srspinho/KBD_16_MENU/hardware/fab/kbd16_esquematico.pdf

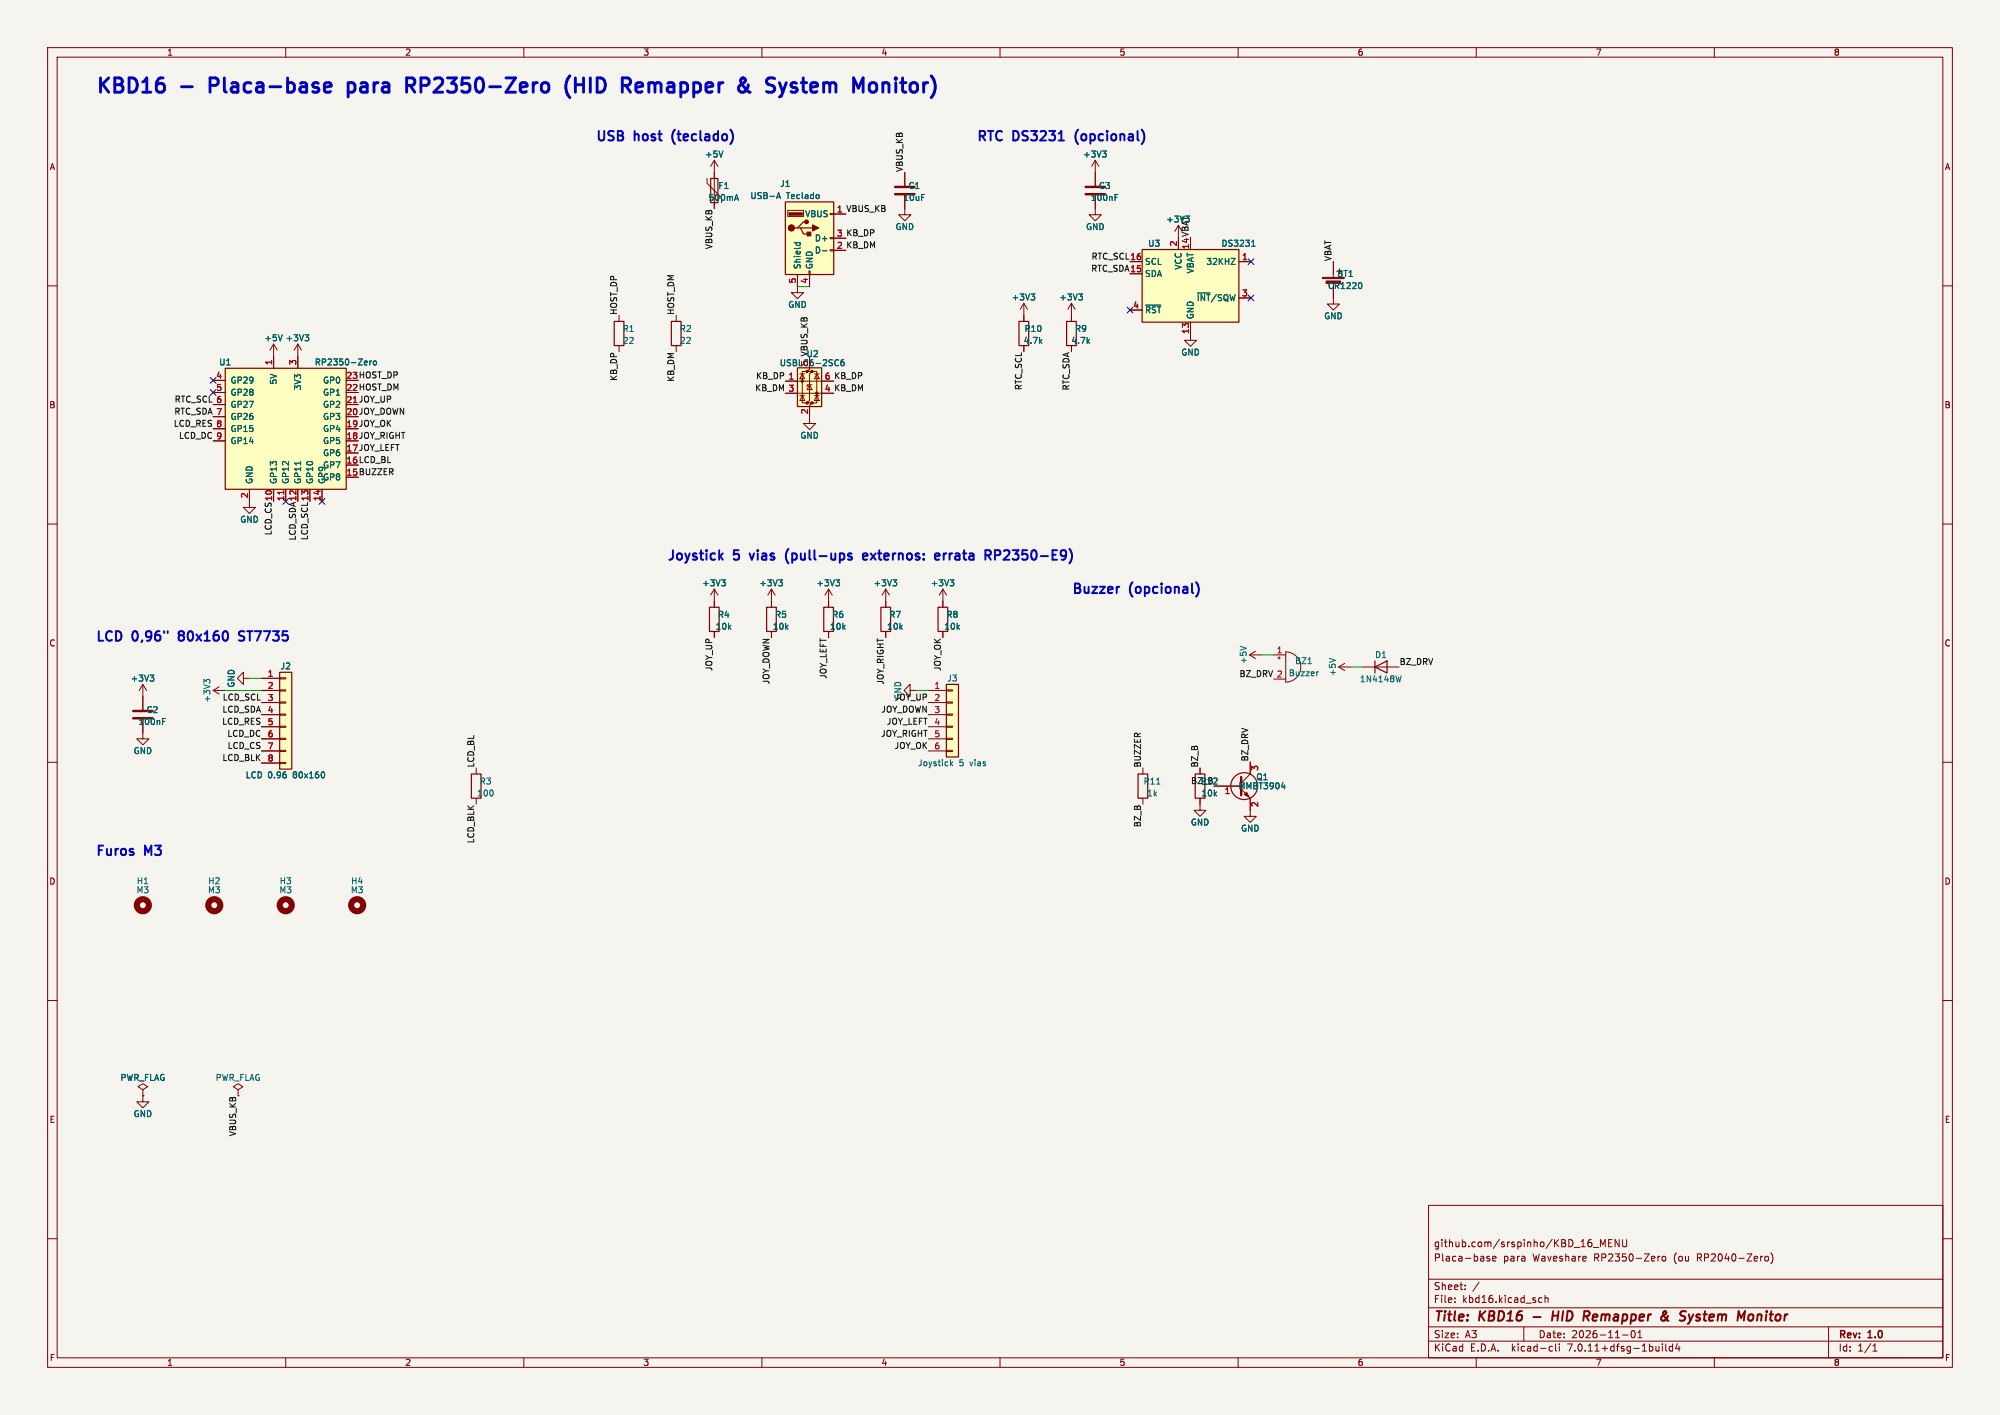
[picture p3: page 1]

2 ~{INT}/SQW3 ~{RST} 4 GND GND
