srspinho/KBD_16_MENU/hardware/fab/kbd16_placa_1x1.pdf

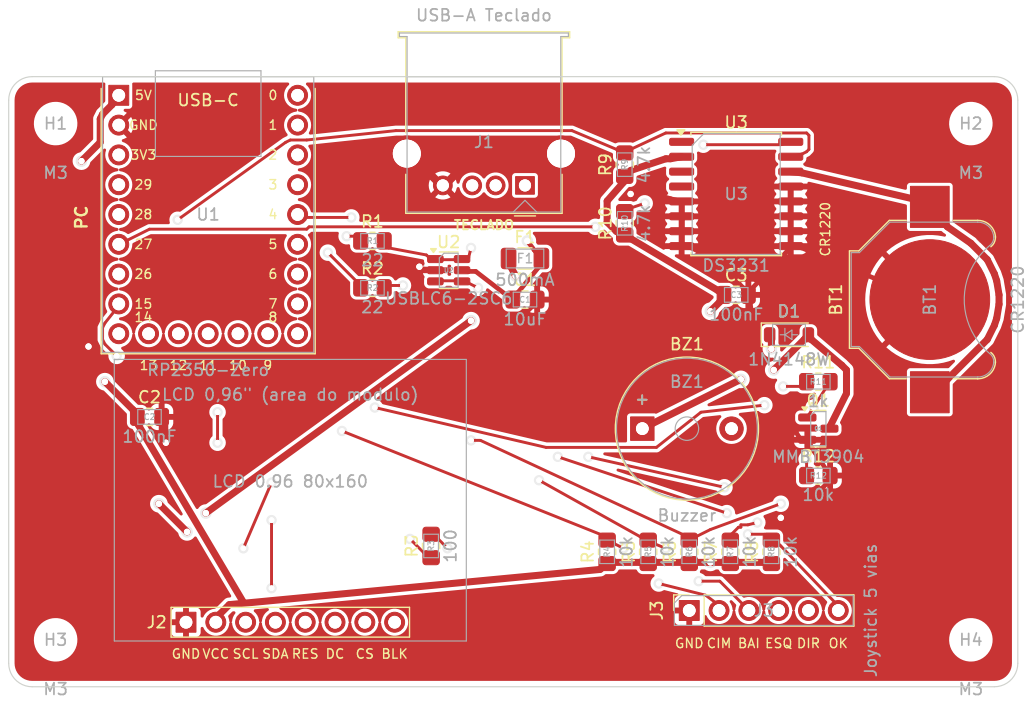
[picture p4: page 1]
