srspinho/KBD_16_MENU/hardware/kbd16.kicad_pcb

## KiCad design hardware/kbd16.kicad_pcb (2026-11-01)

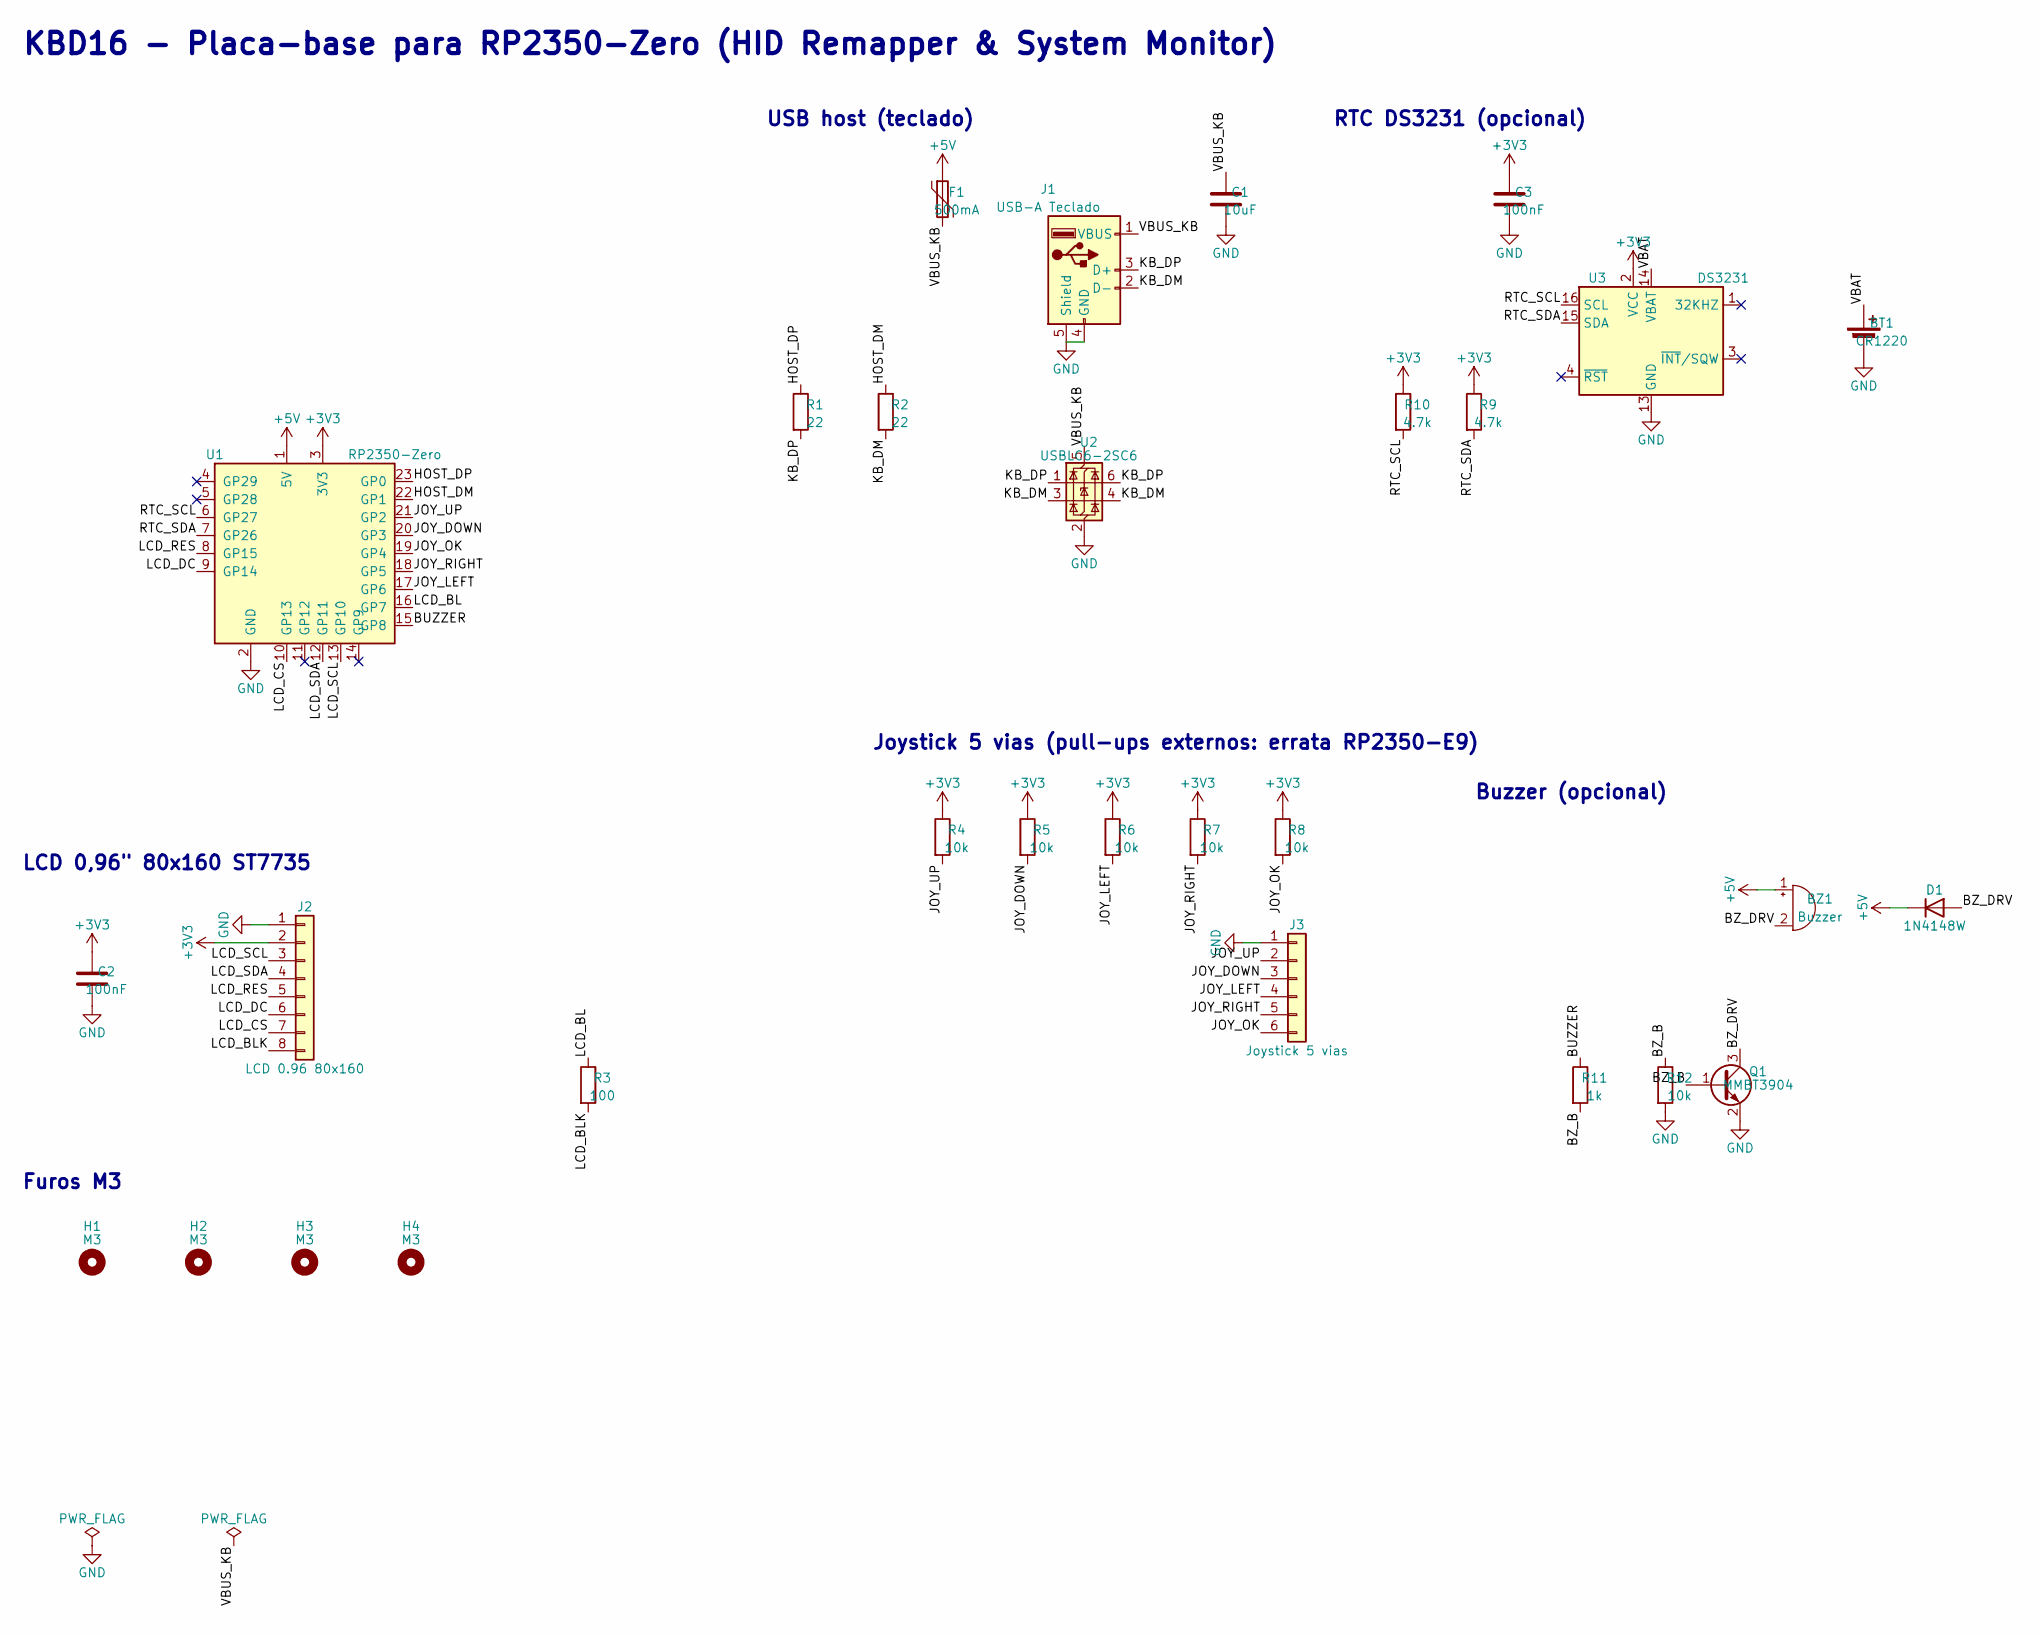
[picture p5: schematic kbd16.kicad_sch, KBD16 - HID Remapper & System Monitor]

Parts:
BT1: CR1220; BatteryHolder_Keystone_3000_1x12mm; MPN Keystone 3000
BZ1: Buzzer; Buzzer_12x9.5RM7.6; MPN TMB12A05 (passivo)
C1: 10uF; C_0805_2012Metric_Pad1.18x1.45mm_HandSolder
C2, C3: 100nF; C_0805_2012Metric_Pad1.18x1.45mm_HandSolder
D1: 1N4148W; D_SOD-123; MPN 1N4148W
F1: 500mA; Fuse_1206_3216Metric; MPN 1206L050
H1, H2, H3, H4: M3; MountingHole_3.2mm_M3
J1: USB-A Teclado; USB_A_Molex_67643_Horizontal; MPN Molex 67643-0910
J2: LCD 0.96 80x160; LCD_0.96_80x160_Socket
J3: Joystick 5 vias; PinSocket_1x06_P2.54mm_Vertical
Q1: MMBT3904; SOT-23; MPN MMBT3904
R1, R2: 22; R_0805_2012Metric_Pad1.20x1.40mm_HandSolder
R3: 100; R_0805_2012Metric_Pad1.20x1.40mm_HandSolder
R4, R5, R6, R7, R8, R12: 10k; R_0805_2012Metric_Pad1.20x1.40mm_HandSolder
R9, R10: 4.7k; R_0805_2012Metric_Pad1.20x1.40mm_HandSolder
R11: 1k; R_0805_2012Metric_Pad1.20x1.40mm_HandSolder
U1: RP2350-Zero; MPN Waveshare RP2350-Zero
U2: USBLC6-2SC6; SOT-23-6; MPN USBLC6-2SC6
U3: DS3231; SOIC-16W_7.5x10.3mm_P1.27mm; MPN DS3231SN#

Connections:
+3V3: C2.1, C3.1, J2.2, R4.1, R5.1, R6.1, R7.1, R8.1, R9.1, R10.1, U1.3 (3V3), U3.2 (VCC)
+5V: BZ1.1 (+), D1.1 (K), F1.1, U1.1 (5V)
/BUZZER: R11.1, U1.15 (GP8)
/BZ_B: Q1.1 (B), R11.2, R12.1
/BZ_DRV: BZ1.2 (-), D1.2 (A), Q1.3 (C)
/HOST_DM: R2.1, U1.22 (GP1)
/HOST_DP: R1.1, U1.23 (GP0)
/JOY_DOWN: J3.3, R5.2, U1.20 (GP3)
/JOY_LEFT: J3.4, R6.2, U1.17 (GP6)
/JOY_OK: J3.6, R8.2, U1.19 (GP4)
/JOY_RIGHT: J3.5, R7.2, U1.18 (GP5)
/JOY_UP: J3.2, R4.2, U1.21 (GP2)
/KB_DM: J1.2 (D-), R2.2, U2.3 (I/O2), U2.4 (I/O2)
/KB_DP: J1.3 (D+), R1.2, U2.1 (I/O1), U2.6 (I/O1)
/LCD_BL: R3.1, U1.16 (GP7)
/LCD_BLK: J2.8, R3.2
/LCD_CS: J2.7, U1.10 (GP13)
/LCD_DC: J2.6, U1.9 (GP14)
/LCD_RES: J2.5, U1.8 (GP15)
/LCD_SCL: J2.3, U1.13 (GP10)
/LCD_SDA: J2.4, U1.12 (GP11)
/RTC_SCL: R10.2, U1.6 (GP27), U3.16 (SCL)
/RTC_SDA: R9.2, U1.7 (GP26), U3.15 (SDA)
/VBAT: BT1.1 (+), U3.14 (VBAT)
/VBUS_KB: C1.1, F1.2, J1.1 (VBUS), U2.5 (VBUS)
GND: BT1.2 (-), C1.2, C2.2, C3.2, J1.4 (GND), J1.5 (Shield), J2.1, J3.1, Q1.2 (E), R12.2, U1.2 (GND), U2.2 (GND), U3.5 (GND), U3.6 (GND), U3.7 (GND), U3.8 (GND), U3.9 (GND), U3.10 (GND), U3.11 (GND), U3.12 (GND), U3.13 (GND)

Notes on the sheet:
KBD16 - Placa-base para RP2350-Zero (HID Remapper & System Monitor)
USB host (teclado)
LCD 0,96" 80x160 ST7735
Joystick 5 vias (pull-ups externos: errata RP2350-E9)
RTC DS3231 (opcional)
Buzzer (opcional)
Furos M3

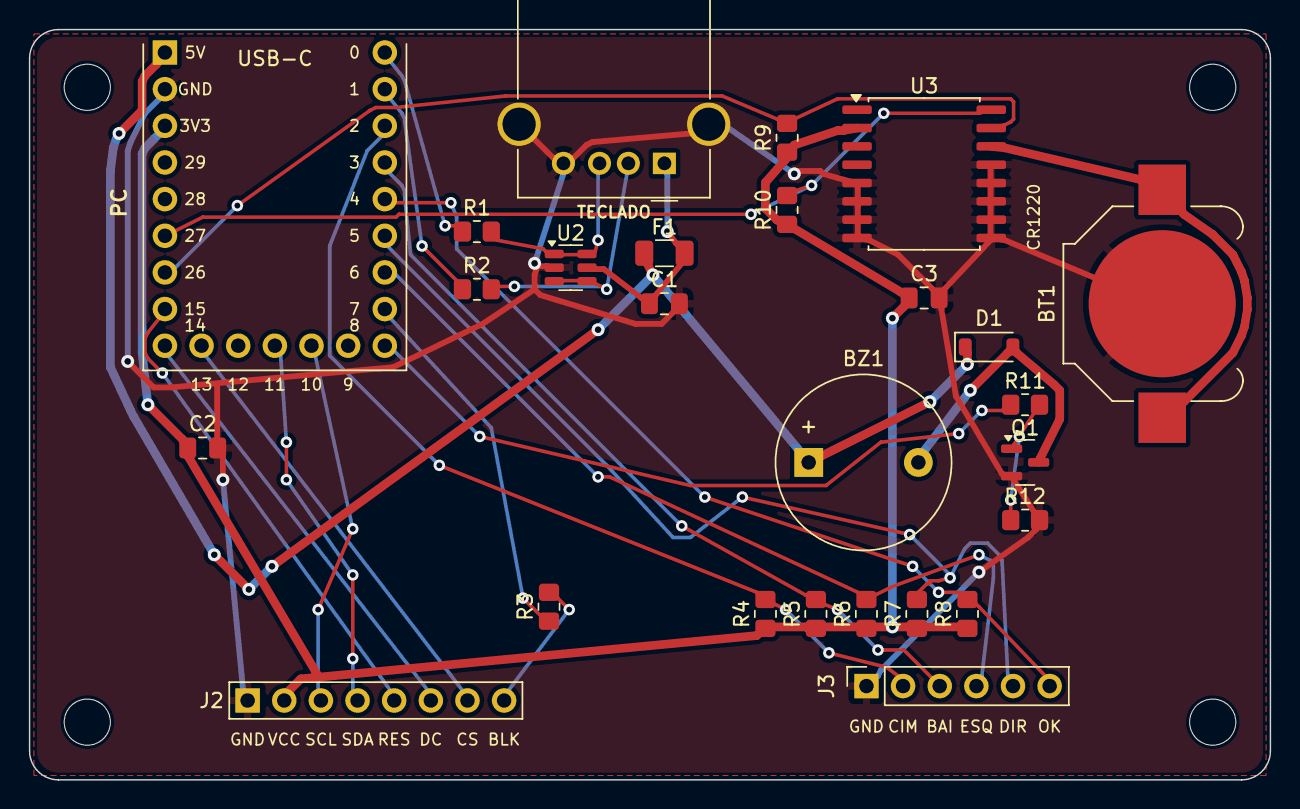
[picture p6: board kbd16.kicad_pcb from above]

Board: 2 copper layers, 86.0 x 52.0 mm, 30 parts (0 on the bottom side), 26 nets.
