srspinho/KBD_16_MENU/app.h

/*********************************************************************
 * app.h - Lógica principal do core 0
 *********************************************************************/
#ifndef APP_H
#define APP_H

void app_setup();
void app_loop();

#endif
