srspinho/KBD_16_MENU/(commit log)

2026-06-07 Clean up TFT pin definitions in README
    Removed unused TFT pin definitions and updated pinout table.
2026-10-31 Reestrutura o firmware em módulos, corrige bugs e adiciona funções (v3)
    Arquitetura
    - Divide o .ino de ~1400 linhas em módulos (app, ui, menu, screensavers,
    usb_bridge, settings, stats, clock, pomodoro, buttons, display, keymap).
    - Core 1 passa a ser o único a enviar reports ao PC (fila sem perdas) e a
    falar com o teclado; core 0 conversa com ele por filas lock-free.
    - Screensavers numa tabela comum, todos desenhando num sprite único.
    - Menu orientado a dados, com auto-repetição, rolagem, confirmação e timeout.
    Correções
    - Menu: só o 1º item de cada submenu podia ser editado (índice zerado).
    - Contagem de teclas com keycode >= 64 (setas, F8-F12, numpad) era UB.
    - Report d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
2026-10-31 Adiciona testes de host da ponte USB e das estatísticas
    Compila usb_bridge.cpp, keymap.cpp, shared.cpp e stats.cpp no PC com
    stubs das bibliotecas e verifica remapeamento com latch, camada Fn,
    macros, fila sem perda de reports, rollover, desconexão do teclado,
    teclas de mídia, LEDs, PC suspenso, KPM e ranking de teclas.
    Claude-Session: https://claude.ai/code/session_01PQLPSZqDPZifgT83uFLmk4
2026-10-31 Atualiza o README para a versão 3
    Documenta controles, menu, novas funções, pinagem (backlight, RTC,
    buzzer), compilação, estrutura do código, testes e limitações.
    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
2026-11-01 Adiciona a placa KiCad para o RP2350-Zero
    Projeto KiCad completo (esquemático, PCB roteada, biblioteca própria)
    de uma placa-base de 86 x 52 mm, 2 camadas, para o Waveshare
    RP2350-Zero (ou RP2040-Zero): USB-A do teclado com polyfuse e ESD,
    soquetes do LCD 0,96" e do joystick com pull-ups externos, RTC DS3231
    com CR1220, buzzer com driver e 4 furos M3.
    - DRC sem erros e sem conexões faltando; esquemático e PCB conferidos
    automaticamente contra a definição única em tools/design.py.
    - fab/: Gerbers + furação (zip), BOM, posição, esquemático em PDF e
    placa em escala 1:1 para conferir as peças.
    - tools/: scripts que regeneram tudo (inclui um roteador A* próprio).
    Co-Authored-B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
2026-11-01 Ajusta firmware e README para a placa com RP2350-Zero
    - Buzzer no GP8 (PIN_BUZZER), como na placa KiCad.
    - Documenta a placa Waveshare RP2350 Zero e o clock de 120 MHz
    (o padrão de 150 MHz do RP2350 não funciona com o USB host).
    - README aponta para hardware/.
    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
2026-11-02 Troca o screensaver Bolas por uma simulação do Pong clássico
    - pong_game.cpp: física e "IA" do Pong separadas do desenho (sem
    dependência de Arduino), com saque, pausa após o ponto, bola que
    acelera a cada rebatida, ângulo conforme o ponto da raquete,
    jogadores que preveem a trajetória mas erram de vez em quando e
    partida até 11.
    - Placar em dígitos "blocados" no estilo do original; o placar do
    vencedor pisca no fim da partida.
    - O Pong ocupa a posição das antigas Bolas na lista (quem usava Bolas
    passa a ver o Pong).
    - test/host/test_pong.cpp: 3 milhões de quadros conferindo bola dentro
    do campo, vitórias dos dois lados, duração das trocas e dos pontos.
    Co-Auth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
